simonyiszk/sem18-pcb/hw/sem18.kicad_pcb

## KiCad design hw/sem18.kicad_pcb (2026-05-08)

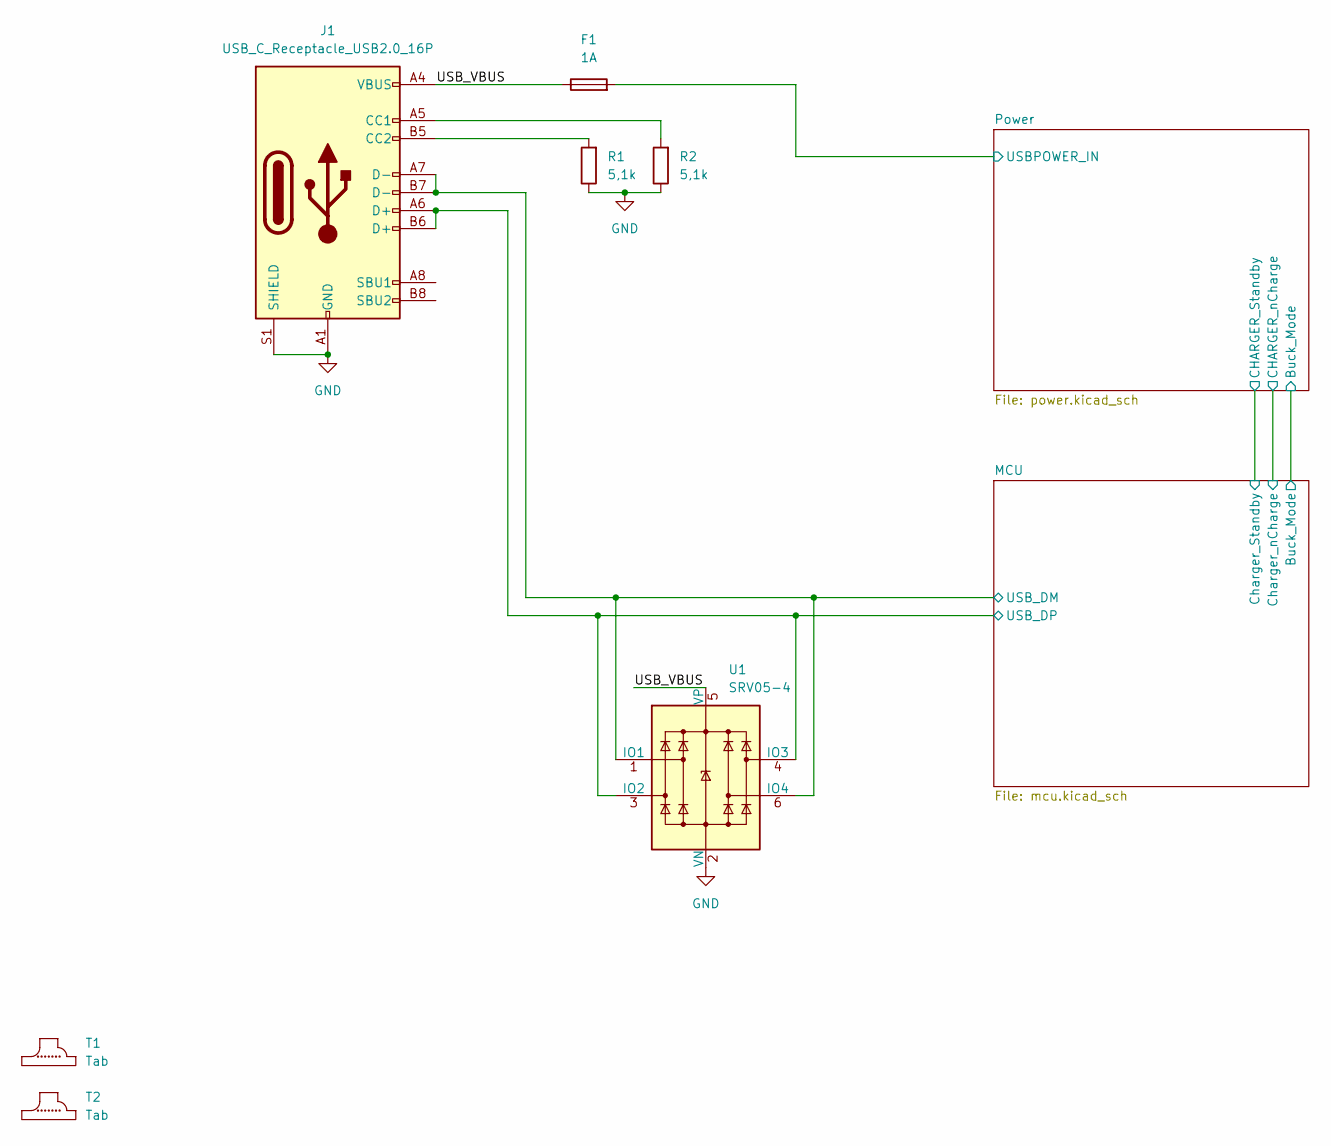
[picture p1: schematic sem18.kicad_sch]

Parts:
F1: 1A; Fuse_1206_3216Metric
J1: USB_C_Receptacle_USB2.0_16P; USB_C_Receptacle_G-Switch_GT-USB-7010ASV
R1, R2: 5,1k; R_0603_1608Metric
T1, T2: Tab
U1: SRV05-4; SOT-23-6

Connections:
/MCU/USB_DM: J1.A7 (D-), J1.B7 (D-), U1.1 (IO1), U1.6 (IO4); also elsewhere on the board
/MCU/USB_DP: J1.A6 (D+), J1.B6 (D+), U1.3 (IO2), U1.4 (IO3); also elsewhere on the board
/Power/USBPOWER_IN: F1.2; also elsewhere on the board
/USB_VBUS: F1.1, J1.A4 (VBUS), J1.A9 (VBUS), J1.B4 (VBUS), J1.B9 (VBUS), U1.5 (VP)
GND: J1.A1 (GND), J1.A12 (GND), J1.B1 (GND), J1.B12 (GND), J1.S1 (SHIELD), R1.1, R2.1, U1.2 (VN); also elsewhere on the board
unnamed: J1.A5 (CC1), R2.2
unnamed: J1.B5 (CC2), R1.2

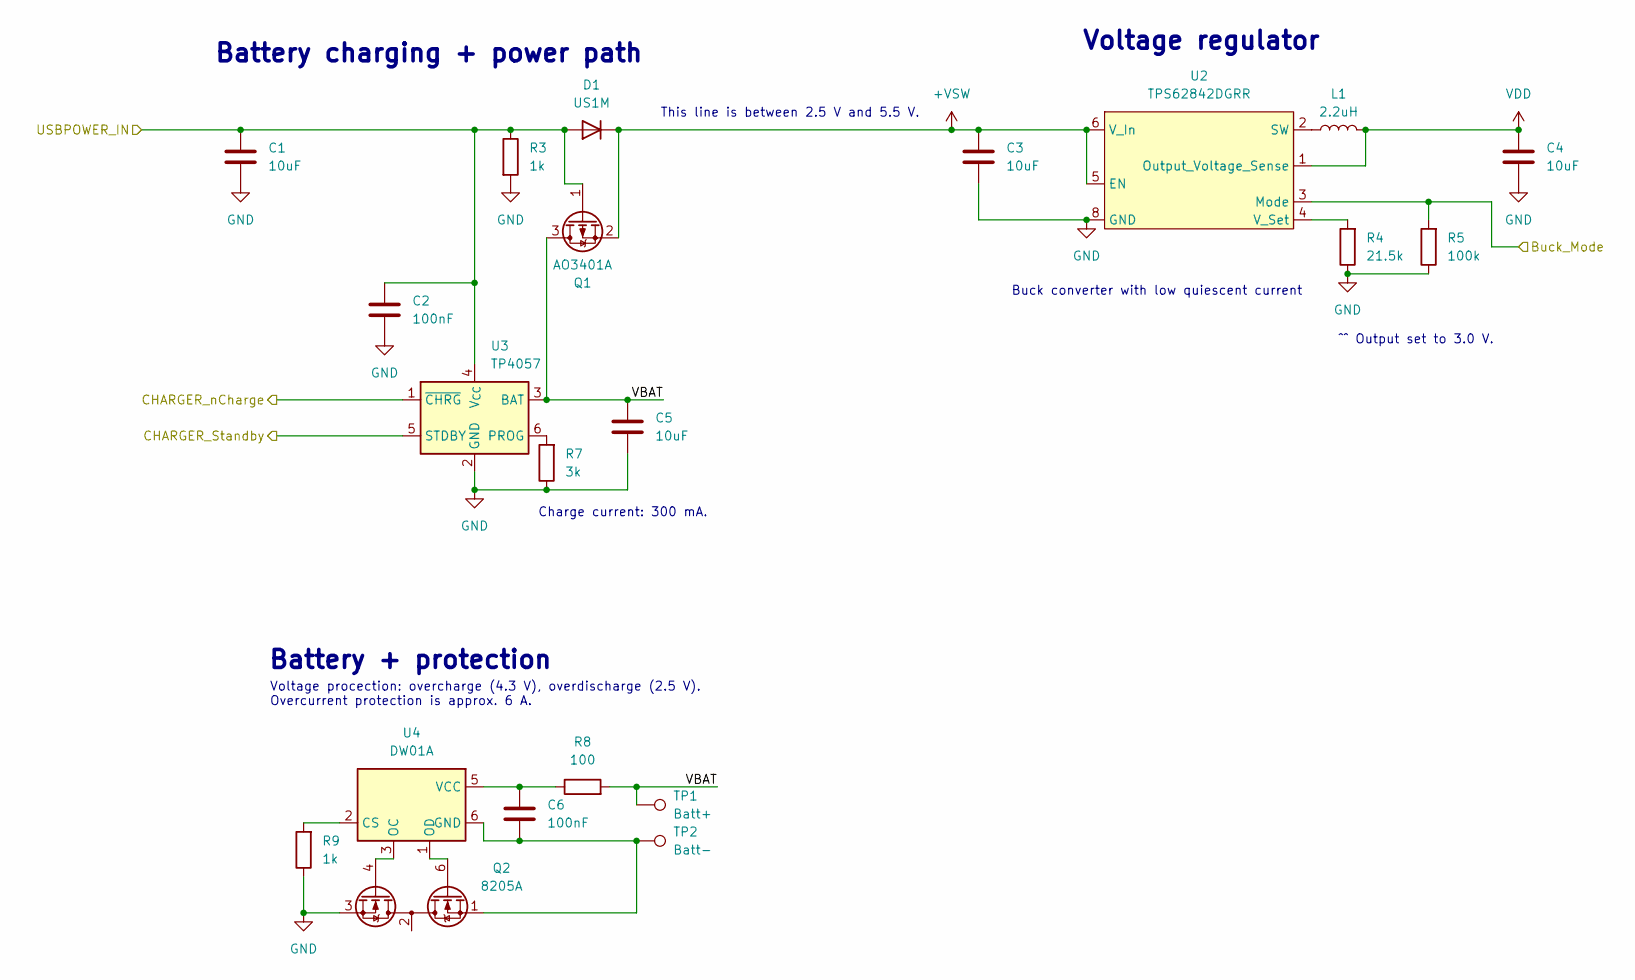
[picture p2: schematic power.kicad_sch]

Parts:
C1, C3, C4, C5: 10uF; C_0805_2012Metric
C2, C6: 100nF; C_0603_1608Metric
D1: US1M; D_SMA
L1: 2.2uH; L_APV_ANR3012
Q1: AO3401A; SOT-23
Q2: 8205A; SOT-23-6
R3, R9: 1k; R_0603_1608Metric
R4: 21.5k; R_0603_1608Metric
R5: 100k; R_0603_1608Metric
R7: 3k; R_0603_1608Metric
R8: 100; R_0603_1608Metric
TP1: Batt+; SolderWirePad_1x01_SMD_1x2mm
TP2: Batt-; SolderWirePad_1x01_SMD_1x2mm
U2: TPS62842DGRR; HVSSOP-8-1EP_3x3mm_P0.65mm_EP1.57x1.89mm
U3: TP4057; TSOT-23-6
U4: DW01A; SOT-23-6

Connections:
+VSW: C3.1, D1.1 (K), Q1.2 (S), U2.5 (EN), U2.6 (V_In); also elsewhere on the board
/MCU/Buck_Mode: R5.2, U2.3 (Mode); also elsewhere on the board
/MCU/Charger_Standby: U3.5 (STDBY); also elsewhere on the board
/MCU/Charger_nCharge: U3.1 (~CHRG); also elsewhere on the board
/Power/USBPOWER_IN: C1.1, C2.2, D1.2 (A), Q1.1 (G), R3.1, U3.4 (V_{CC}); also elsewhere on the board
/Power/VBAT: C5.1, Q1.3 (D), R8.2, TP1.1, U3.3 (BAT)
GND: C1.2, C2.1, C3.2, C4.2, C5.2, Q2.3 (S2), R3.2, R4.1, R5.1, R7.1, R9.1, U2.8 (GND), U2.9 (GND), U3.2 (GND); also elsewhere on the board
unnamed: C6.2, Q2.1 (D1), TP2.1, U4.6 (GND)
unnamed: Q2.6 (G1), U4.1 (OD)
unnamed: Q2.4 (G2), U4.3 (OC)
unnamed: Q2.2 (S1/D2), Q2.5 (S1/D2)
unnamed: L1.1, U2.2 (SW)
unnamed: R4.2, U2.4 (V_Set)
unnamed: R7.2, U3.6 (PROG)
unnamed: R9.2, U4.2 (CS)
unnamed: C6.1, R8.1, U4.5 (VCC)
VDD: C4.1, L1.2, U2.1 (Output_Voltage_Sense); also elsewhere on the board

Notes on the sheet:
Buck converter with low quiescent current
Charge current: 300 mA.
Voltage procection: overcharge (4.3 V), overdischarge (2.5 V). Overcurrent protection is approx. 6 A.
This line is between 2.5 V and 5.5 V.
Battery charging + power path
Voltage regulator
^^ Output set to 3.0 V.
Battery + protection

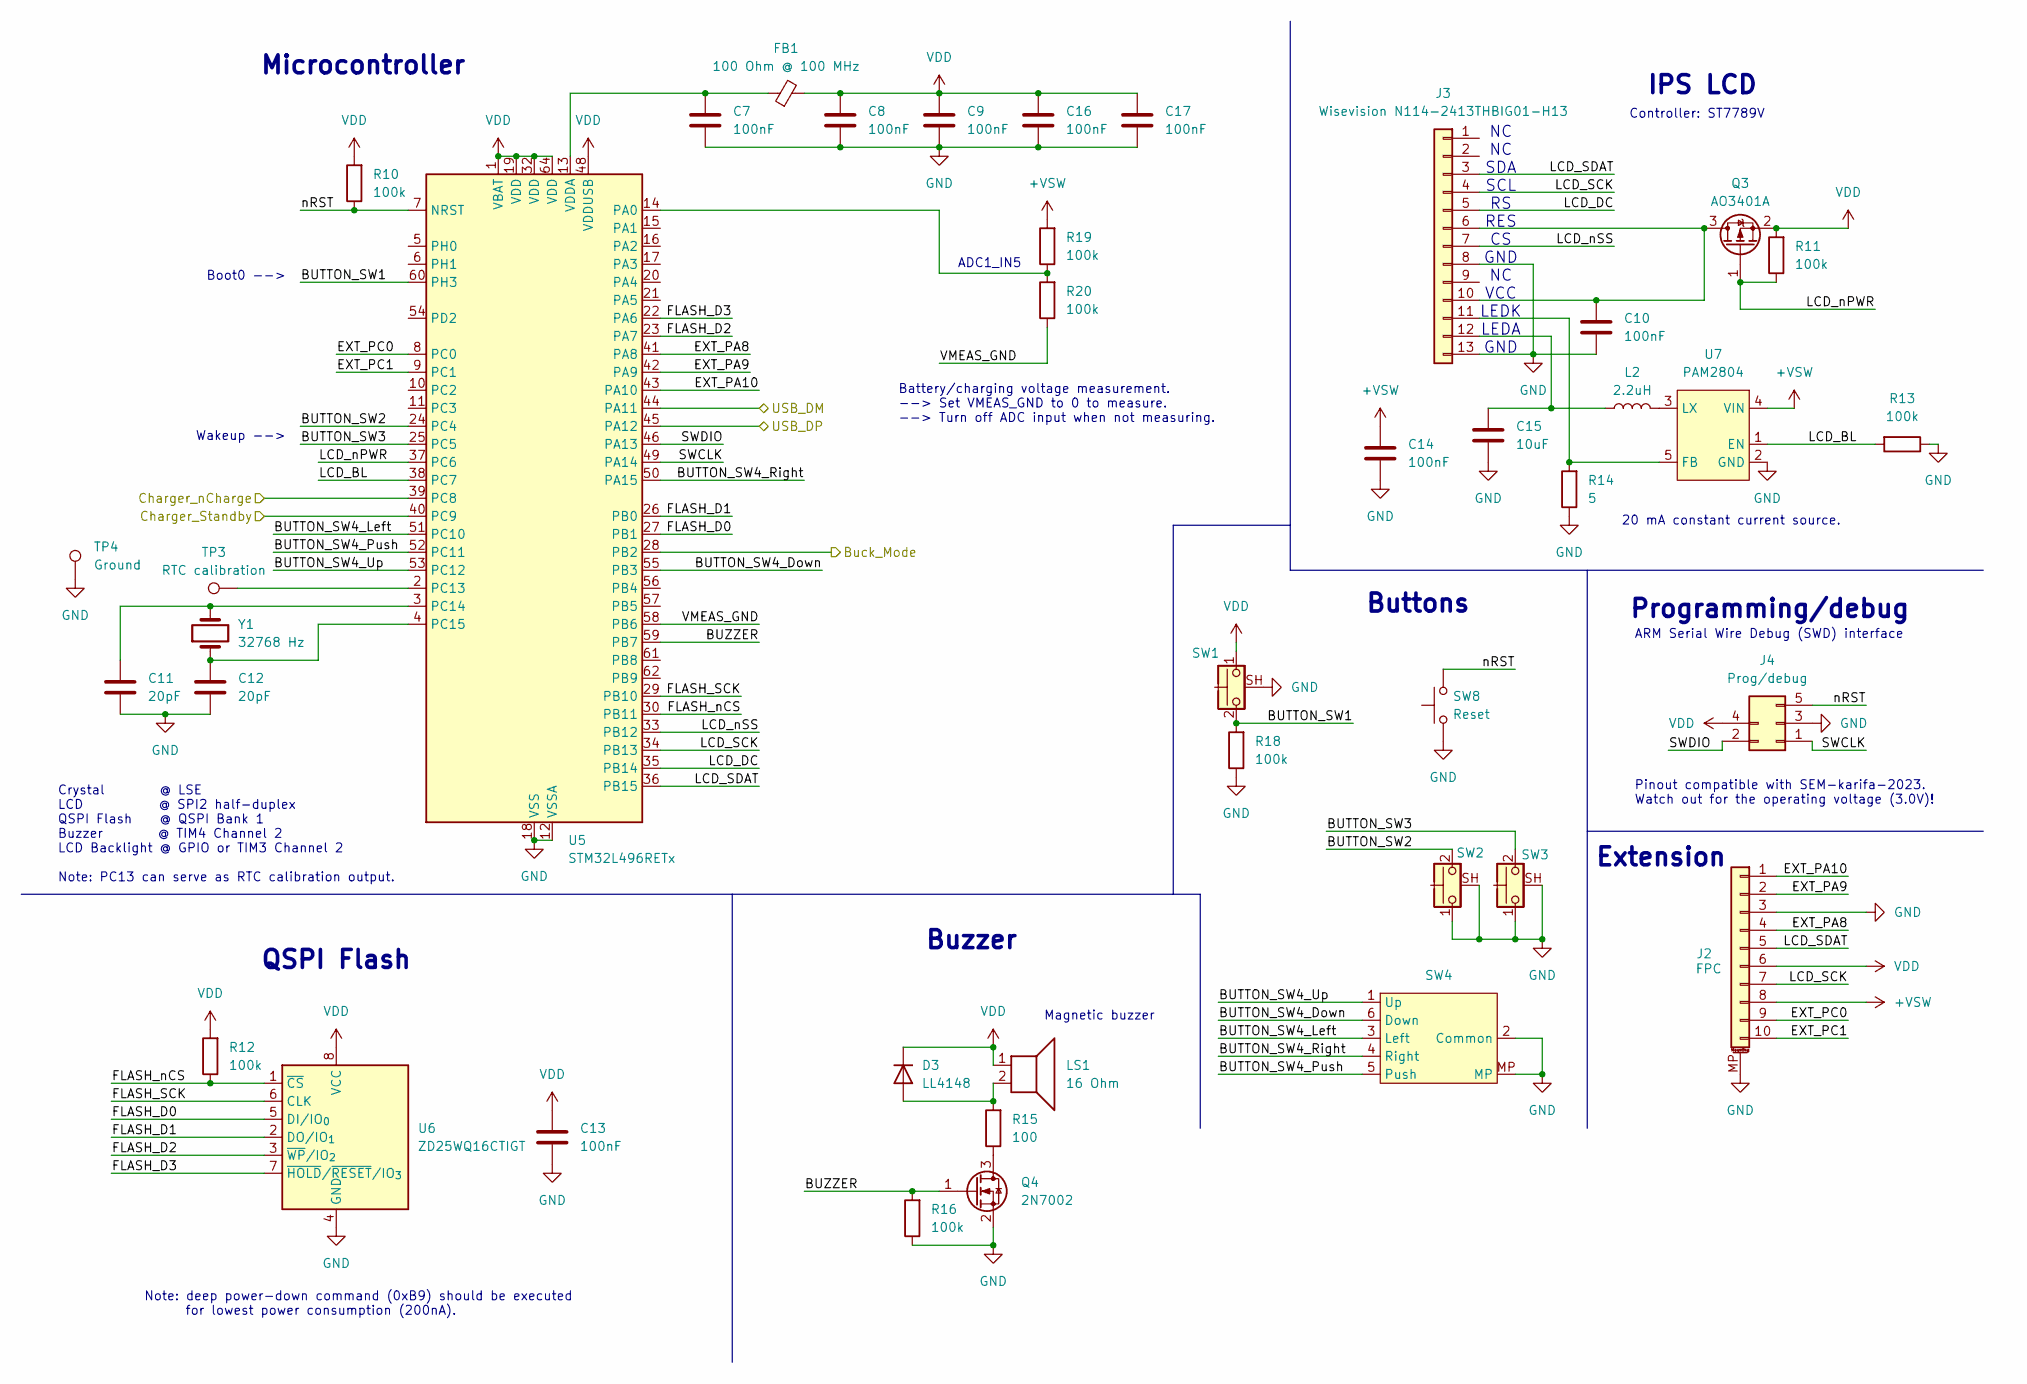
[picture p3: schematic mcu.kicad_sch]

Parts:
C7, C8, C9, C10, C13, C14, C16, C17: 100nF; C_0603_1608Metric
C11, C12: 20pF; C_0603_1608Metric
C15: 10uF; C_0805_2012Metric
D3: LL4148; D_MiniMELF
FB1: 100 Ohm @ 100 MHz; L_0805_2012Metric
J2: FPC; Hirose_FH12-10S-0.5SH_1x10-1MP_P0.50mm_Horizontal
J3: Wisevision N114-2413THBIG01-H13; LCD_ST7789V_13pin
J4: Prog/debug; ProgConnector_5pin
L2: 2.2uH; L_APV_ANR3012
LS1: 16 Ohm; Buzzer_8.5x8.5mm
Q3: AO3401A; SOT-23
Q4: 2N7002; SOT-23
R10, R11, R12, R13, R16, R18, R19, R20: 100k; R_0603_1608Metric
R14: 5; R_0603_1608Metric
R15: 100; R_0603_1608Metric
SW1, SW2, SW3: SW_Push_Shielded; SMD_Tactile_Switch_7.7x3.6mm_Right-angle
SW4: SMD_Directional_Switch
SW8: Reset; SW_SPST_TL3342
TP3: RTC calibration; TestPoint_Pad_D1.0mm
TP4: Ground; TestPoint_Pad_D1.0mm
U5: STM32L496RETx; LQFP-64_10x10mm_P0.5mm
U6: ZD25WQ16CTIGT; SOIC-8_5.3x5.3mm_P1.27mm
U7: PAM2804; SOT-23-5
Y1: 32768 Hz; Crystal_DS26_D2.0mm_L6.0mm_Vertical

Connections:
+VSW: C14.2, J2.8, R19.2, U7.4 (VIN); also elsewhere on the board
/MCU/BUTTON_SW1: R18.2, SW1.2, U5.60 (PH3)
/MCU/BUTTON_SW2: SW2.2, U5.24 (PC4)
/MCU/BUTTON_SW3: SW3.2, U5.25 (PC5)
/MCU/BUTTON_SW4_Down: SW4.6 (Down), U5.55 (PB3)
/MCU/BUTTON_SW4_Left: SW4.3 (Left), U5.51 (PC10)
/MCU/BUTTON_SW4_Push: SW4.5 (Push), U5.52 (PC11)
/MCU/BUTTON_SW4_Right: SW4.4 (Right), U5.50 (PA15)
/MCU/BUTTON_SW4_Up: SW4.1 (Up), U5.53 (PC12)
/MCU/BUZZER: Q4.1 (G), R16.2, U5.59 (PB7)
/MCU/Buck_Mode: U5.28 (PB2); also elsewhere on the board
/MCU/Charger_Standby: U5.40 (PC9); also elsewhere on the board
/MCU/Charger_nCharge: U5.39 (PC8); also elsewhere on the board
/MCU/EXT_PA8: J2.4, U5.41 (PA8)
/MCU/EXT_PA9: J2.2, U5.42 (PA9)
/MCU/EXT_PA10: J2.1, U5.43 (PA10)
/MCU/EXT_PC0: J2.9, U5.8 (PC0)
/MCU/EXT_PC1: J2.10, U5.9 (PC1)
/MCU/FLASH_D0: U5.27 (PB1), U6.5 (DI/IO_{0})
/MCU/FLASH_D1: U5.26 (PB0), U6.2 (DO/IO_{1})
/MCU/FLASH_D2: U5.23 (PA7), U6.3 (~WP/IO_{2})
/MCU/FLASH_D3: U5.22 (PA6), U6.7 (~HOLD/~RESET/IO_{3})
/MCU/FLASH_SCK: U5.29 (PB10), U6.6 (CLK)
/MCU/FLASH_nCS: R12.1, U5.30 (PB11), U6.1 (~CS)
/MCU/LCD_BL: R13.2, U5.38 (PC7), U7.1 (EN)
/MCU/LCD_DC: J3.5, U5.35 (PB14)
/MCU/LCD_SCK: J2.7, J3.4, U5.34 (PB13)
/MCU/LCD_SDAT: J2.5, J3.3, U5.36 (PB15)
/MCU/LCD_nPWR: Q3.1 (G), R11.1, U5.37 (PC6)
/MCU/LCD_nSS: J3.7, U5.33 (PB12)
/MCU/SWCLK: J4.1, U5.49 (PA14)
/MCU/SWDIO: J4.2, U5.46 (PA13)
/MCU/USB_DM: U5.44 (PA11); also elsewhere on the board
/MCU/USB_DP: U5.45 (PA12); also elsewhere on the board
/MCU/VMEAS_GND: R20.1, U5.58 (PB6)
/MCU/nRST: J4.5, R10.1, SW8.2, U5.7 (NRST)
GND: C7.1, C8.1, C9.1, C10.1, C11.1, C12.1, C13.1, C14.1, C15.2, C16.1, C17.1, J2.3, J2.MP (MountPin), J3.8, J3.13, J4.3, Q4.2 (S), R13.1, R14.1, R16.1, R18.1, SW1.SH (B), SW2.1, SW2.SH (B), SW3.1, SW3.SH (B), SW4.2 (Common), SW4.MP, SW8.1, TP4.1, U5.12 (VSSA), U5.18 (VSS), U5.31 (VSS), U5.47 (VSS), U5.63 (VSS), U6.4 (GND), U7.2 (GND); also elsewhere on the board
unnamed: D3.2 (A), LS1.2, R15.2
unnamed: C10.2, J3.6, J3.10, Q3.3 (D)
unnamed: J3.11, R14.2, U7.5 (FB)
unnamed: C15.1, J3.12, L2.1
unnamed: Q4.3 (D), R15.1
unnamed: R19.1, R20.2, U5.14 (PA0)
unnamed: TP3.1, U5.2 (PC13)
unnamed: C11.2, U5.3 (PC14), Y1.2
unnamed: C12.2, U5.4 (PC15), Y1.1
unnamed: C7.2, FB1.1, U5.13 (VDDA)
unnamed: L2.2, U7.3 (LX)
VDD: C8.2, C9.2, C13.2, C16.2, C17.2, D3.1 (K), FB1.2, J2.6, J4.4, LS1.1, Q3.2 (S), R10.2, R11.2, R12.2, SW1.1, U5.1 (VBAT), U5.19 (VDD), U5.32 (VDD), U5.48 (VDDUSB), U5.64 (VDD), U6.8 (VCC); also elsewhere on the board

Notes on the sheet:
IPS LCD
Note: deep power-down command (0xB9) should be executed for lowest power consumption (200nA).
Boot0 -->
Extension
Pinout compatible with SEM-karifa-2023. Watch out for the operating voltage (3.0V)!
Crystal @ LSE LCD @ SPI2 half-duplex QSPI Flash @ QSPI Bank 1 Buzzer @ TIM4 Channel 2 LCD Backlight @ GPIO or TIM3 Channel 2 Note: PC13 can serve as RTC calibration output.
Magnetic buzzer
NC NC SDA SCL RS RES CS GND NC VCC LEDK LEDA GND
Buttons
Battery/charging voltage measurement. --> Set VMEAS_GND to 0 to measure. --> Turn off ADC input when not measuring.
Programming/debug
ARM Serial Wire Debug (SWD) interface
Controller: ST7789V
20 mA constant current source.
Buzzer
QSPI Flash
Microcontroller
ADC1_IN5
Wakeup -->

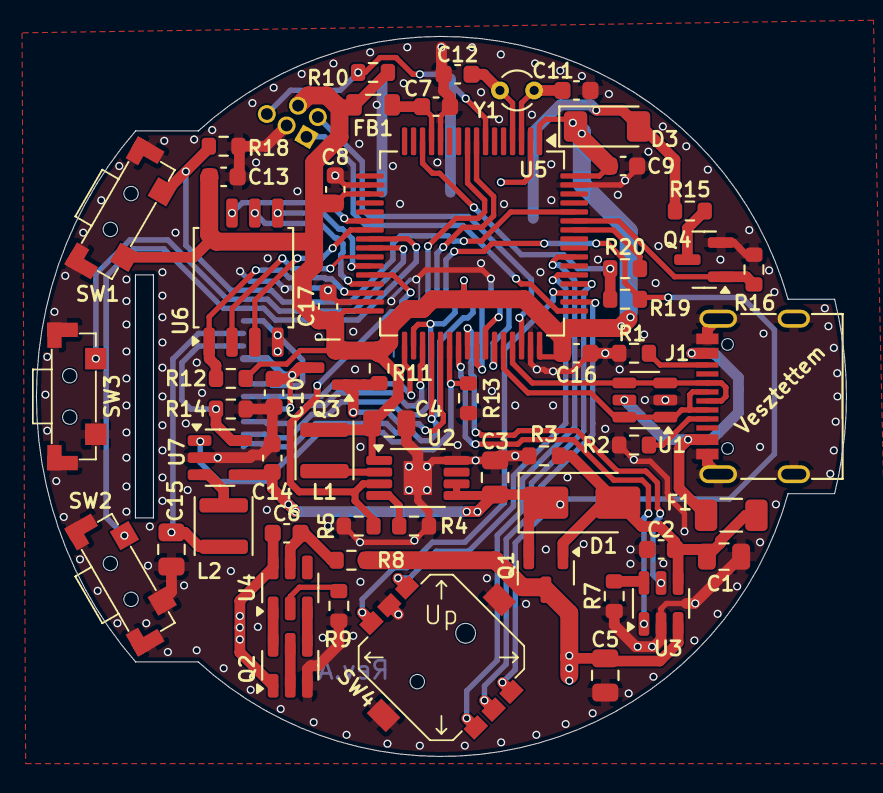
[picture p4: board sem18.kicad_pcb from above]

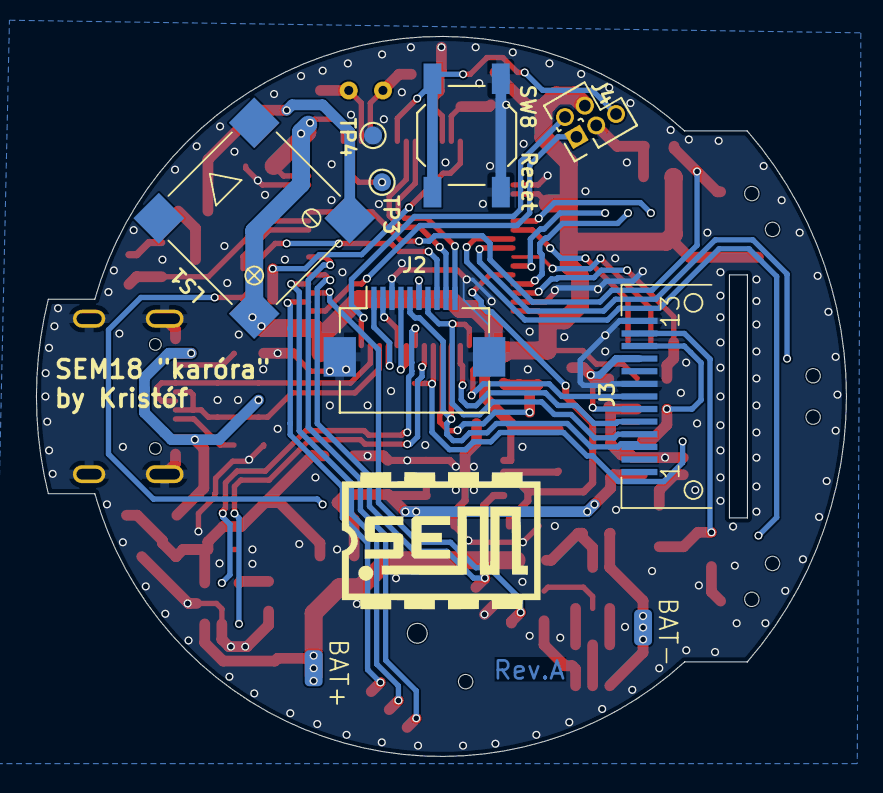
[picture p5: board sem18.kicad_pcb from below]

Board: 4 copper layers, 45.0 x 40.0 mm, 69 parts (9 on the bottom side), 63 nets.
