simonyiszk/sem18-pcb/fw/fw.ioc

Mcu.UserName=STM32L496RETx
PA0.Signal=ADCx_IN5
PA11.Signal=USB_OTG_FS_DM
PA12.Signal=USB_OTG_FS_DP
PA6.Signal=QUADSPI_BK1_IO3
PA7.Signal=QUADSPI_BK1_IO2
PB0.Signal=QUADSPI_BK1_IO1
PB1.Signal=QUADSPI_BK1_IO0
PB10.Signal=QUADSPI_CLK
PB11.Signal=QUADSPI_BK1_NCS
PB12.GPIO_Label=LCD_nSS
PB12.Signal=GPIO_Output
PB13.Signal=SPI2_SCK
PB14.GPIO_Label=LCD_DC
PB14.Signal=GPIO_Output
PB15.Signal=SPI2_MOSI
PB2.GPIO_Label=BUCK_MODE
PB2.Signal=GPIO_Output
PB6.GPIO_Label=VMEAS_GND
PB6.Signal=GPIO_Output
PB7.GPIO_Label=BUZZER
PB7.Signal=S_TIM4_CH2
PC10.GPIO_Label=BUTTON_SW4_LEFT
PC10.Signal=GPIO_Input
PC11.GPIO_Label=BUTTON_SW4_PUSH
PC11.Signal=GPIO_Input
PC12.GPIO_Label=BUTTON_SW4_UP
PC12.Signal=GPIO_Input
PC4.GPIO_Label=BUTTON_SW2
PC4.Signal=GPIO_Input
PC5.GPIO_Label=BUTTON_SW3
PC5.Signal=GPIO_Input
PC6.GPIO_Label=LCD_nPWR
PC6.Signal=GPIO_Output
PC7.GPIO_Label=LCD_BL
PC7.Signal=GPIO_Output
PC8.GPIO_Label=CHARGER_nCHARGE
PC8.Signal=GPIO_Input
PC9.GPIO_Label=CHARGER_STANDBY
PC9.Signal=GPIO_Input
PH3-BOOT0.GPIO_Label=BUTTON_SW1
PH3-BOOT0.Signal=GPIO_Input
