simonyiszk/sem18-pcb/fw/Core/Src/gpio.c

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

/* Includes ------------------------------------------------------------------*/
#include "gpio.h"

/*----------------------------------------------------------------------------*/
/* Configure GPIO                                                             */
/*----------------------------------------------------------------------------*/
/** Configure pins as
        * Analog
        * Input
        * Output
        * EVENT_OUT
        * EXTI
        * Free pins are configured automatically as Analog (this feature is enabled through
        * the Code Generation settings)
*/
void MX_GPIO_Init(void)
{

  GPIO_InitTypeDef GPIO_InitStruct = {0};

  /* GPIO Ports Clock Enable */
  __HAL_RCC_GPIOC_CLK_ENABLE();
  __HAL_RCC_GPIOA_CLK_ENABLE();
  __HAL_RCC_GPIOB_CLK_ENABLE();
  __HAL_RCC_GPIOH_CLK_ENABLE();

  /*Configure GPIO pin Output Level */
  HAL_GPIO_WritePin(GPIOB, BUCK_MODE_Pin|LCD_DC_Pin, GPIO_PIN_RESET);

  /*Configure GPIO pin Output Level */
  HAL_GPIO_WritePin(GPIOB, LCD_nSS_Pin|VMEAS_GND_Pin, GPIO_PIN_SET);

  /*Configure GPIO pin Output Level */
  HAL_GPIO_WritePin(LCD_nPWR_GPIO_Port, LCD_nPWR_Pin, GPIO_PIN_SET);

  /*Configure GPIO pin Output Level */
  HAL_GPIO_WritePin(LCD_BL_GPIO_Port, LCD_BL_Pin, GPIO_PIN_RESET);

  /*Configure GPIO pins : PC13 PC0 PC1 */
  GPIO_InitStruct.Pin = GPIO_PIN_13|GPIO_PIN_0|GPIO_PIN_1;
  GPIO_InitStruct.Mode = GPIO_MODE_ANALOG;
  GPIO_InitStruct.Pull = GPIO_NOPULL;
  HAL_GPIO_Init(GPIOC, &GPIO_InitStruct);

  /*Configure GPIO pins : BUTTON_SW2_Pin BUTTON_SW3_Pin CHARGER_nCHARGE_Pin CHARGER_STANDBY_Pin
                           BUTTON_SW4_LEFT_Pin BUTTON_SW4_PUSH_Pin BUTTON_SW4_UP_Pin */
  GPIO_InitStruct.Pin = BUTTON_SW2_Pin|BUTTON_SW3_Pin|CHARGER_nCHARGE_Pin|CHARGER_STANDBY_Pin
                          |BUTTON_SW4_LEFT_Pin|BUTTON_SW4_PUSH_Pin|BUTTON_SW4_UP_Pin;
  GPIO_InitStruct.Mode = GPIO_MODE_INPUT;
  GPIO_InitStruct.Pull = GPIO_PULLUP;
  HAL_GPIO_Init(GPIOC, &GPIO_InitStruct);

  /*Configure GPIO pin : BUCK_MODE_Pin */
  GPIO_InitStruct.Pin = BUCK_MODE_Pin;
  GPIO_InitStruct.Mode = GPIO_MODE_OUTPUT_PP;
  GPIO_InitStruct.Pull = GPIO_NOPULL;
  GPIO_InitStruct.Speed = GPIO_SPEED_FREQ_MEDIUM;
  HAL_GPIO_Init(BUCK_MODE_GPIO_Port, &GPIO_InitStruct);

  /*Configure GPIO pin : LCD_nSS_Pin */
  GPIO_InitStruct.Pin = LCD_nSS_Pin;
  GPIO_InitStruct.Mode = GPIO_MODE_OUTPUT_PP;
  GPIO_InitStruct.Pull = GPIO_NOPULL;
  GPIO_InitStruct.Speed = GPIO_SPEED_FREQ_VERY_HIGH;
  HAL_GPIO_Init(LCD_nSS_GPIO_Port, &GPIO_InitStruct);

  /*Configure GPIO pin : LCD_DC_Pin */
  GPIO_InitStruct.Pin = LCD_DC_Pin;
  GPIO_InitStruct.Mode = GPIO_MODE_OUTPUT_PP;
  GPIO_InitStruct.Pull = GPIO_NOPULL;
  GPIO_InitStruct.Speed = GPIO_SPEED_FREQ_LOW;
  HAL_GPIO_Init(LCD_DC_GPIO_Port, &GPIO_InitStruct);

  /*Configure GPIO pin : LCD_nPWR_Pin */
  GPIO_InitStruct.Pin = LCD_nPWR_Pin;
  GPIO_InitStruct.Mode = GPIO_MODE_OUTPUT_OD;
  GPIO_InitStruct.Pull = GPIO_NOPULL;
  GPIO_InitStruct.Speed = GPIO_SPEED_FREQ_MEDIUM;
  HAL_GPIO_Init(LCD_nPWR_GPIO_Port, &GPIO_InitStruct);

  /*Configure GPIO pin : LCD_BL_Pin */
  GPIO_InitStruct.Pin = LCD_BL_Pin;
  GPIO_InitStruct.Mode = GPIO_MODE_OUTPUT_PP;
  GPIO_InitStruct.Pull = GPIO_NOPULL;
  GPIO_InitStruct.Speed = GPIO_SPEED_FREQ_MEDIUM;
  HAL_GPIO_Init(LCD_BL_GPIO_Port, &GPIO_InitStruct);

  /*Configure GPIO pins : PA8 PA9 PA10 */
  GPIO_InitStruct.Pin = GPIO_PIN_8|GPIO_PIN_9|GPIO_PIN_10;
  GPIO_InitStruct.Mode = GPIO_MODE_ANALOG;
  GPIO_InitStruct.Pull = GPIO_NOPULL;
  HAL_GPIO_Init(GPIOA, &GPIO_InitStruct);

  /*Configure GPIO pin : BUTTON_SW4_RIGHT_Pin */
  GPIO_InitStruct.Pin = BUTTON_SW4_RIGHT_Pin;
  GPIO_InitStruct.Mode = GPIO_MODE_INPUT;
  GPIO_InitStruct.Pull = GPIO_PULLUP;
  HAL_GPIO_Init(BUTTON_SW4_RIGHT_GPIO_Port, &GPIO_InitStruct);

  /*Configure GPIO pin : BUTTON_SW4_DOWN_Pin */
  GPIO_InitStruct.Pin = BUTTON_SW4_DOWN_Pin;
  GPIO_InitStruct.Mode = GPIO_MODE_INPUT;
  GPIO_InitStruct.Pull = GPIO_PULLUP;
  HAL_GPIO_Init(BUTTON_SW4_DOWN_GPIO_Port, &GPIO_InitStruct);

  /*Configure GPIO pin : VMEAS_GND_Pin */
  GPIO_InitStruct.Pin = VMEAS_GND_Pin;
  GPIO_InitStruct.Mode = GPIO_MODE_OUTPUT_OD;
  GPIO_InitStruct.Pull = GPIO_NOPULL;
  GPIO_InitStruct.Speed = GPIO_SPEED_FREQ_VERY_HIGH;
  HAL_GPIO_Init(VMEAS_GND_GPIO_Port, &GPIO_InitStruct);

  /*Configure GPIO pin : BUTTON_SW1_Pin */
  GPIO_InitStruct.Pin = BUTTON_SW1_Pin;
  GPIO_InitStruct.Mode = GPIO_MODE_INPUT;
  GPIO_InitStruct.Pull = GPIO_PULLDOWN;
  HAL_GPIO_Init(BUTTON_SW1_GPIO_Port, &GPIO_InitStruct);

}
