simonyiszk/sem18-pcb/fw/Core/Inc/main.h

#define BUTTON_SW2_Pin GPIO_PIN_4
#define BUTTON_SW2_GPIO_Port GPIOC
#define BUTTON_SW3_Pin GPIO_PIN_5
#define BUTTON_SW3_GPIO_Port GPIOC
#define BUCK_MODE_Pin GPIO_PIN_2
#define BUCK_MODE_GPIO_Port GPIOB
#define LCD_nSS_Pin GPIO_PIN_12
#define LCD_nSS_GPIO_Port GPIOB
#define LCD_DC_Pin GPIO_PIN_14
#define LCD_DC_GPIO_Port GPIOB
#define LCD_nPWR_Pin GPIO_PIN_6
#define LCD_nPWR_GPIO_Port GPIOC
#define LCD_BL_Pin GPIO_PIN_7
#define LCD_BL_GPIO_Port GPIOC
#define CHARGER_nCHARGE_Pin GPIO_PIN_8
#define CHARGER_nCHARGE_GPIO_Port GPIOC
#define CHARGER_STANDBY_Pin GPIO_PIN_9
#define CHARGER_STANDBY_GPIO_Port GPIOC
#define BUTTON_SW4_RIGHT_Pin GPIO_PIN_15
#define BUTTON_SW4_RIGHT_GPIO_Port GPIOA
#define BUTTON_SW4_LEFT_Pin GPIO_PIN_10
#define BUTTON_SW4_LEFT_GPIO_Port GPIOC
#define BUTTON_SW4_PUSH_Pin GPIO_PIN_11
#define BUTTON_SW4_PUSH_GPIO_Port GPIOC
#define BUTTON_SW4_UP_Pin GPIO_PIN_12
#define BUTTON_SW4_UP_GPIO_Port GPIOC
#define BUTTON_SW4_DOWN_Pin GPIO_PIN_3
#define BUTTON_SW4_DOWN_GPIO_Port GPIOB
#define VMEAS_GND_Pin GPIO_PIN_6
#define VMEAS_GND_GPIO_Port GPIOB
#define BUZZER_Pin GPIO_PIN_7
#define BUZZER_GPIO_Port GPIOB
#define BUTTON_SW1_Pin GPIO_PIN_3
#define BUTTON_SW1_GPIO_Port GPIOH
