simonyiszk/sem18-pcb/fw/Core/Src/rtc.c

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
/* Includes ------------------------------------------------------------------*/
#include "rtc.h"

RTC_HandleTypeDef hrtc;

/* RTC init function */
void MX_RTC_Init(void)
{

  RTC_TimeTypeDef sTime = {0};
  RTC_DateTypeDef sDate = {0};

  /** Initialize RTC Only
  */
  hrtc.Instance = RTC;
  hrtc.Init.HourFormat = RTC_HOURFORMAT_24;
  hrtc.Init.AsynchPrediv = 127;
  hrtc.Init.SynchPrediv = 255;
  hrtc.Init.OutPut = RTC_OUTPUT_DISABLE;
  hrtc.Init.OutPutRemap = RTC_OUTPUT_REMAP_NONE;
  hrtc.Init.OutPutPolarity = RTC_OUTPUT_POLARITY_HIGH;
  hrtc.Init.OutPutType = RTC_OUTPUT_TYPE_OPENDRAIN;
  if (HAL_RTC_Init(&hrtc) != HAL_OK)
  {
    Error_Handler();
  }

  /* USER CODE BEGIN Check_RTC_BKUP */
  HAL_PWR_EnableBkUpAccess();
  /* Check if the system was resumed from shutdown mode,
     resort to RTC back-up register RTC_BKP31R to verify 
     whether or not shutdown entry flag was set by software
     before entering shutdown mode.  */
  if( READ_REG(RTC->BKP31R) == 1 )
  {
     WRITE_REG( RTC->BKP31R, 0x0 );  /* reset back-up register */
     return;  // don't reset the RTC
  }
  /* USER CODE END Check_RTC_BKUP */

  /** Initialize RTC and set the Time and Date
  */
  sTime.Hours = 0x0;
  sTime.Minutes = 0x0;
  sTime.Seconds = 0x0;
  sTime.DayLightSaving = RTC_DAYLIGHTSAVING_NONE;
  sTime.StoreOperation = RTC_STOREOPERATION_RESET;
  if (HAL_RTC_SetTime(&hrtc, &sTime, RTC_FORMAT_BCD) != HAL_OK)
  {
    Error_Handler();
  }
  sDate.WeekDay = RTC_WEEKDAY_MONDAY;
  sDate.Month = RTC_MONTH_JANUARY;
  sDate.Date = 0x1;
  sDate.Year = 0x0;

  if (HAL_RTC_SetDate(&hrtc, &sDate, RTC_FORMAT_BCD) != HAL_OK)
  {
    Error_Handler();
  }
}

void HAL_RTC_MspInit(RTC_HandleTypeDef* rtcHandle)
{

  if(rtcHandle->Instance==RTC)
  {
  if(LL_RCC_GetRTCClockSource() != LL_RCC_RTC_CLKSOURCE_LSE)
  {
    FlagStatus pwrclkchanged = RESET;
    /* Update LSE configuration in Backup Domain control register */
    /* Requires to enable write access to Backup Domain if necessary */
    if (LL_APB1_GRP1_IsEnabledClock (LL_APB1_GRP1_PERIPH_PWR) != 1U)
    {
      /* Enables the PWR Clock and Enables access to the backup domain */
      LL_APB1_GRP1_EnableClock(LL_APB1_GRP1_PERIPH_PWR);
      pwrclkchanged = SET;
    }
    if (LL_PWR_IsEnabledBkUpAccess () != 1U)
    {
      /* Enable write access to Backup domain */
      LL_PWR_EnableBkUpAccess();
      while (LL_PWR_IsEnabledBkUpAccess () == 0U)
      {
      }
    }
    LL_RCC_ForceBackupDomainReset();
    LL_RCC_ReleaseBackupDomainReset();
    LL_RCC_LSE_SetDriveCapability(LL_RCC_LSEDRIVE_LOW);
    LL_RCC_LSE_Enable();

   /* Wait till LSE is ready */
    while(LL_RCC_LSE_IsReady() != 1)
    {
    }
    LL_RCC_SetRTCClockSource(LL_RCC_RTC_CLKSOURCE_LSE);
    /* Restore clock configuration if changed */
    if (pwrclkchanged == SET)
    {
      LL_APB1_GRP1_DisableClock(LL_APB1_GRP1_PERIPH_PWR);
    }
  }

    /* RTC clock enable */
    __HAL_RCC_RTC_ENABLE();
  }
}

void HAL_RTC_MspDeInit(RTC_HandleTypeDef* rtcHandle)
{

  if(rtcHandle->Instance==RTC)
  {
    /* Peripheral clock disable */
    __HAL_RCC_RTC_DISABLE();
  }
}
