simonyiszk/sem18-pcb/fw/src/buzzer.c

/*! *******************************************************************************************************
* Copyright (c) 2025 K. Sz. Horvath
*
* All rights reserved
*
* \file buzzer.c
*
* \brief Buzzer driver using Timer in PWM mode
*
* \author K. Sz. Horvath
*
**********************************************************************************************************/

//--------------------------------------------------------------------------------------------------------/
// Include files
//--------------------------------------------------------------------------------------------------------/
#include "main.h"
#include "tim.h"

// Own include
#include "buzzer.h"


//--------------------------------------------------------------------------------------------------------/
// Definitions
//--------------------------------------------------------------------------------------------------------/
#define HAL_TIMER_PERIPH   (htim16)                 //!< Timer peripherial used by this driver
#define TIMER_CHANNEL      (TIM_CHANNEL_1)          //!< Timer channel used by this driver
#define PWM_DUTY           (htim16.Instance->CCR1)  //!< PWM duty cycle register
#define CLOCK_FREQ_HZ      (48000000)               //!< Clock frequency of the timer in Hz


//--------------------------------------------------------------------------------------------------------/
// Types
//--------------------------------------------------------------------------------------------------------/


//--------------------------------------------------------------------------------------------------------/
// Global variables
//--------------------------------------------------------------------------------------------------------/


//--------------------------------------------------------------------------------------------------------/
// Static function declarations
//--------------------------------------------------------------------------------------------------------/


//--------------------------------------------------------------------------------------------------------/
// Static functions
//--------------------------------------------------------------------------------------------------------/
/*! *******************************************************************
 * \brief
 * \param
 * \return
 *********************************************************************/

/*! *******************************************************************
 * \brief
 * \param
 * \return
 *********************************************************************/


//--------------------------------------------------------------------------------------------------------/
// Interface functions
//--------------------------------------------------------------------------------------------------------/
/*! *******************************************************************
 * \brief  Initialize module
 * \param  -
 * \return -
 *********************************************************************/
void Buzzer_Init( void )
{
  // Initialize timer
  HAL_TIMER_PERIPH.Init.Period = (uint32_t)( CLOCK_FREQ_HZ/440u ) - 1u;
  HAL_TIM_PWM_Init( &HAL_TIMER_PERIPH );
  PWM_DUTY = 0u;
  HAL_TIM_PWM_Start( &HAL_TIMER_PERIPH, TIMER_CHANNEL );
}

/*! *******************************************************************
 * \brief  Start buzzing
 * \param  u32FrequencyHz: frequency in Hz (min: 1)
 * \param  u8DutyCycle: duty cycle (0..255)
 * \return -
 *********************************************************************/
void Buzzer_Note( uint32_t u32FrequencyHz, uint8_t u8DutyCycle )
{
  uint32_t u32NewPeriod;
  
  // Minimum value: 1 Hz
  if( u32FrequencyHz > 0u )
  {
    // Set frequency
    u32NewPeriod = ( (CLOCK_FREQ_HZ/1000u)/u32FrequencyHz ) - 1u;
    if( u32NewPeriod != HAL_TIMER_PERIPH.Init.Period )  // Set only if it's different from previous value
    {
      HAL_TIMER_PERIPH.Init.Prescaler = 1000u - 1u;
      HAL_TIMER_PERIPH.Init.Period = u32NewPeriod;
      HAL_TIM_PWM_Init( &HAL_TIMER_PERIPH );
    }
    // Set duty cycle
    PWM_DUTY = ( (uint32_t)(HAL_TIMER_PERIPH.Init.Period + 1u) * u8DutyCycle )/255u;
  }
}

/*! *******************************************************************
 * \brief  Stops buzzing
 * \param  -
 * \return -
 *********************************************************************/
void Buzzer_Silence( void )
{
  PWM_DUTY = 0u;
}


//-----------------------------------------------< EOF >--------------------------------------------------/
