simonyiszk/sem18-pcb/fw/Core/Inc/quadspi.h

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
/* Define to prevent recursive inclusion -------------------------------------*/
#ifndef __QUADSPI_H__
#define __QUADSPI_H__

#ifdef __cplusplus
extern "C" {
#endif

/* Includes ------------------------------------------------------------------*/
#include "main.h"

extern QSPI_HandleTypeDef hqspi;

/* USER CODE BEGIN Private defines */


#define MEMORY_FLASH_SIZE                               0x200000  /* 16 MBits => 2 MB */
#define MEMORY_BLOCK_SIZE                               0x10000   /* 64KB block size */
#define MEMORY_SECTOR_SIZE                              0x1000    /* 4kB sector size */
#define MEMORY_PAGE_SIZE                                0x100     /* 256B page size */

/*W25Q64JV commands */

#define CHIP_ERASE_CMD                                  0xC7U
#define READ_STATUS_REG_CMD                             0x05U
#define WRITE_ENABLE_CMD                                0x06U
#define VOLATILE_SR_WRITE_ENABLE                        0x50U
#define READ_STATUS_REG2_CMD                            0x35U
#define WRITE_STATUS_REG2_CMD                           0x31U
#define READ_STATUS_REG3_CMD                            0x15U
#define WRITE_STATUS_REG3_CMD                           0x11U
#define SECTOR_ERASE_CMD                                0x20U
#define BLOCK_ERASE_CMD                                 0xD8U
#define QUAD_IN_FAST_PROG_CMD                           0x32U
#define FAST_PROG_CMD                                   0x02U
#define QUAD_OUT_FAST_READ_CMD                          0x6BU
#define DUMMY_CLOCK_CYCLES_READ_QUAD                    6
#define QUAD_IN_OUT_FAST_READ_CMD                       0xEBU
#define RESET_ENABLE_CMD                                0x66U
#define RESET_EXECUTE_CMD                               0x99U

/* USER CODE END Private defines */

void MX_QUADSPI_Init(void);

#ifdef __cplusplus
}
#endif

#endif /* __QUADSPI_H__ */
