simonyiszk/sem18-pcb/fw/src/buzzer.h

/*! *******************************************************************************************************
* Copyright (c) 2025 K. Sz. Horvath
*
* All rights reserved
*
* \file buzzer.h
*
* \brief Buzzer driver using Timer in PWM mode
*
* \author K. Sz. Horvath
*
**********************************************************************************************************/

#ifndef BUZZER_H
#define BUZZER_H

//--------------------------------------------------------------------------------------------------------/
// Include files
//--------------------------------------------------------------------------------------------------------/


//--------------------------------------------------------------------------------------------------------/
// Definitions
//--------------------------------------------------------------------------------------------------------/


//--------------------------------------------------------------------------------------------------------/
// Types
//--------------------------------------------------------------------------------------------------------/


//--------------------------------------------------------------------------------------------------------/
// Global variables
//--------------------------------------------------------------------------------------------------------/


//--------------------------------------------------------------------------------------------------------/
// Interface functions
//--------------------------------------------------------------------------------------------------------/
void Buzzer_Init( void );
void Buzzer_Note( uint32_t u32FrequencyHz, uint8_t u8DutyCycle );
void Buzzer_Silence( void );



#endif  // BUZZER_H

//-----------------------------------------------< EOF >--------------------------------------------------/
