simonyiszk/sem18-pcb/(commit log)

2026-03-28 Initial commit.
    [mcu.kicad_sch, power.kicad_sch, sem18.kicad_pcb, sem18.kicad_sch]
2026-03-31 Added different voltage regulator.
    [mcu.kicad_sch, power.kicad_sch]
2026-04-02 Schematic is finished. Needs some touch-ups and component selection (esp. for switches).
    [mcu.kicad_sch, power.kicad_sch, sem18.kicad_sch]
2026-04-07 Different microcontroller. Placed most of the components too.
    [mcu.kicad_sch, power.kicad_sch, sem18.kicad_pcb, sem18.kicad_sch]
2026-04-07 Placed remaining components.
    [mcu.kicad_sch, sem18.kicad_pcb]
2026-04-07 Replaced extension connector.
    [mcu.kicad_sch, sem18.kicad_pcb]
2026-04-08 Routing in progress.
    [mcu.kicad_sch, sem18.kicad_pcb]
2026-04-09 Supposedly finished.
    [mcu.kicad_sch, sem18.kicad_pcb]
2026-04-10 Sent to fab.
    [mcu.kicad_sch, panel.kicad_pcb, power.kicad_sch, sem18.kicad_pcb, sem18.kicad_sch]
2026-05-08 Changed naming of the upper left button.
    [mcu.kicad_sch, sem18.kicad_pcb]
