simonyiszk/sem18-pcb/(notices)

Notices in the files:
fw/Core/Inc/quadspi.h:
Copyright (c) 2026 STMicroelectronics.
All rights reserved.
This software is licensed under terms that can be found in the LICENSE file
